friedemann03/Plant-Controller/docs/images/Software_BlockDiagram.png

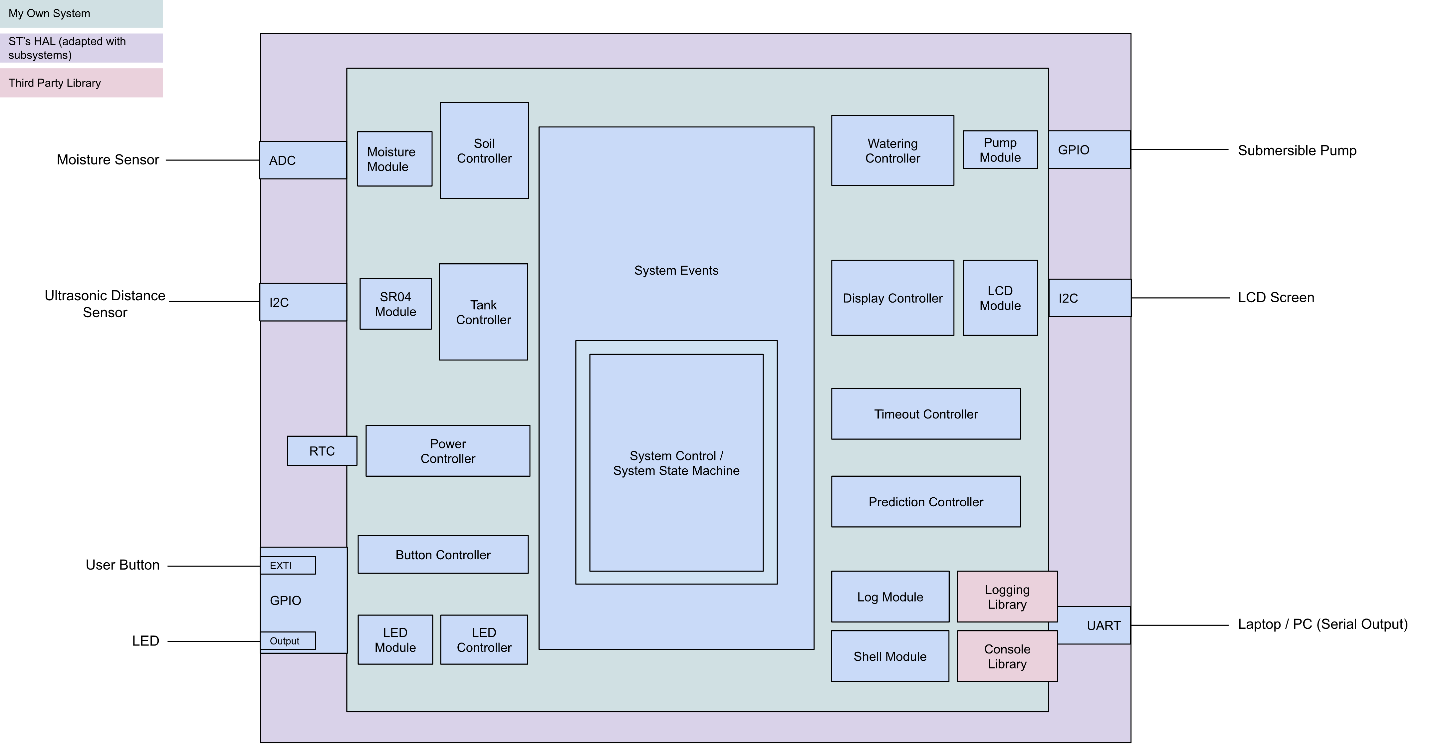
docs/images/Software_BlockDiagram.png
