friedemann03/Plant-Controller/docs/todo.md

# Todo
- [ ] Test Pump System
- [ ] Build the actual system with soil and water tank
- [ ] Design Prediction Controller
- [ ] Implement Prediction Controller
- [ ] Test the whole system

## Future Todos
- [ ] design and build Nucleo Shield PCB
