friedemann03/Plant-Controller/(threads)

Thread 3 (2022-10-17):

System halts when HC-SR04 Sensor's I2C is disconnected

friedemann03, 2022-10-17:
When the Update Function of the Tank Controller gets called while the I2C lines are disconnected, it halts the system, meaning the UART receives nothing anymore and the LED stops blinking.

Thread 4 (2022-10-17):

After System wakes up from STOP Mode, the SR04 does not work anymore

friedemann03, 2022-10-17:
After Stop Mode, the SR04 only return 0mm. I have not yet traced to where this error originates from, could be the controller, the module or the I2C subsystem.

friedemann03, 2022-10-17:
I found the cause of the issue.
The Tank Controller has a state variable (bool) used to see if a started measurement has completed. When entering STOP mode that variable may be left on false, which will cause the Tank Controller to never start a new Measurement.

Solution: After Exiting STOP mode, call the Controller Init function and add an initialisation of that variable to true, to make sure a new measurement gets started.
