friedemann03/Plant-Controller/docs/schematics/prototype_schematic.pdf

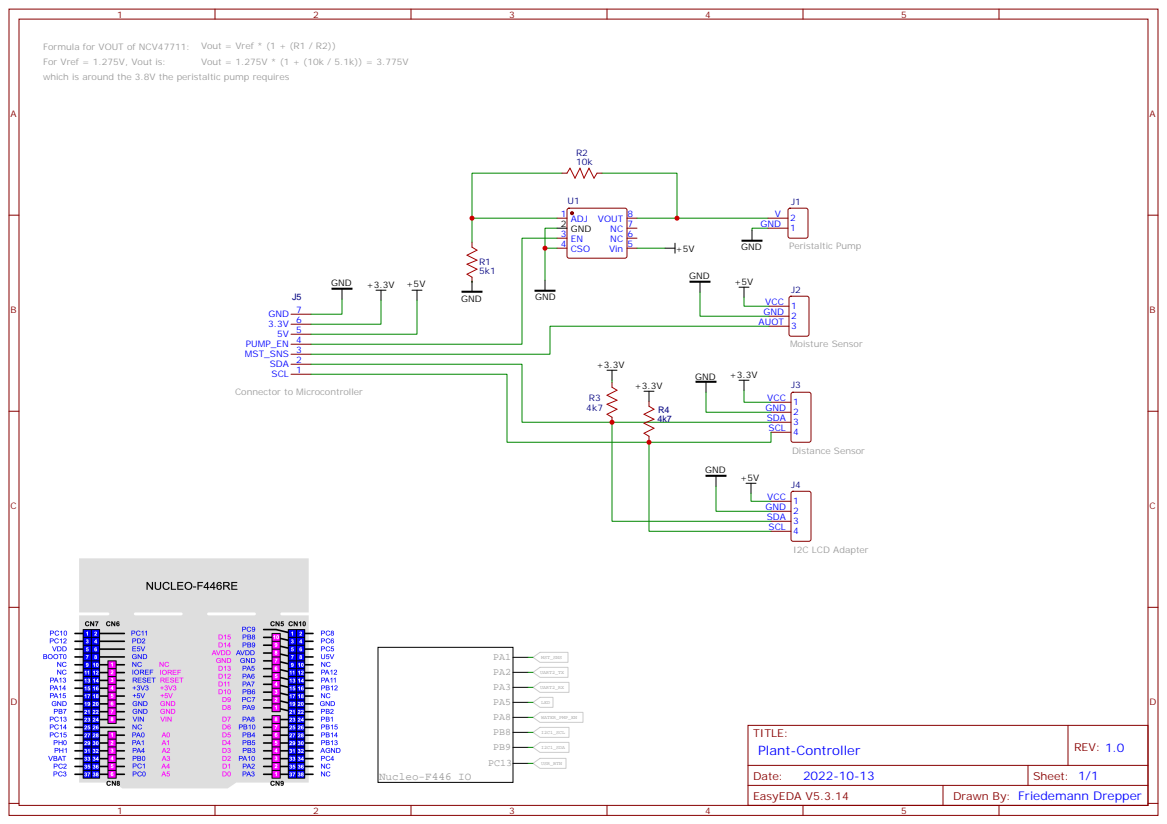
[picture p6: page 1]

Formula for VOUT of NCV47711:
which is around the 3.8V the peristaltic pump requires
