friedemann03/Plant-Controller/Core/Src/main.c

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
/* Includes ------------------------------------------------------------------*/
#include "main.h"

/* USER CODE BEGIN Includes */
#include "subsystem_uart.h"
#include "subsystem_tim.h"
#include "subsystem_gpio.h"
#include "subsystem_i2c.h"
#include "subsystem_adc.h"
#include "subsystem_rtc.h"
#include "log_module.h"
#include "version.h"
#include "system_control.h"
/* USER CODE END Includes */


void SystemClock_Config(void);
/**
  * @brief  The application entry point.
  * @retval int
  */
int main(void)
{
  /* MCU Configuration--------------------------------------------------------*/

  /* Reset of all peripherals, Initializes the Flash interface and the Systick. */
  HAL_Init();

  /* Configure the system clock */
  SystemClock_Config();

  /* Initialize all configured peripherals */
  /* USER CODE BEGIN 2 */

  Uart_Subsystem_Init();
  Log_Module_Init();

  Reset_Log();

  Gpio_Subsystem_Init();
  Tim_Subsystem_Init();
  I2c_Subsystem_Init();
  Adc_Subsystem_Init();
  Rtc_Subsystem_Init();

  System_Control_Init();
  System_Control_Start();
  /* USER CODE END 2 */

  /* Infinite loop */
  /* USER CODE BEGIN WHILE */
#pragma clang diagnostic push
#pragma ide diagnostic ignored "EndlessLoop"
#pragma ide diagnostic ignored "UnreachableCode"
  while (1)
  {
    /* USER CODE END WHILE */

    /* USER CODE BEGIN 3 */

  }
#pragma clang diagnostic pop
  /* USER CODE END 3 */
}

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
