friedemann03/Plant-Controller/Core/Inc/main.h

#define B1_Pin LL_GPIO_PIN_13
#define B1_GPIO_Port GPIOC
#define B1_EXTI_IRQn EXTI15_10_IRQn
#define MOISTURE_SENSOR_IN_Pin LL_GPIO_PIN_1
#define MOISTURE_SENSOR_IN_GPIO_Port GPIOA
#define USART_TX_Pin LL_GPIO_PIN_2
#define USART_TX_GPIO_Port GPIOA
#define USART_RX_Pin LL_GPIO_PIN_3
#define USART_RX_GPIO_Port GPIOA
#define LD2_Pin LL_GPIO_PIN_5
#define LD2_GPIO_Port GPIOA
#define WATER_PUMP_EN_Pin LL_GPIO_PIN_8
#define WATER_PUMP_EN_GPIO_Port GPIOA
#define TMS_Pin LL_GPIO_PIN_13
#define TMS_GPIO_Port GPIOA
#define TCK_Pin LL_GPIO_PIN_14
#define TCK_GPIO_Port GPIOA
#define SWO_Pin LL_GPIO_PIN_3
#define SWO_GPIO_Port GPIOB
#define US_SCL_Pin LL_GPIO_PIN_8
#define US_SCL_GPIO_Port GPIOB
#define US_SDA_Pin LL_GPIO_PIN_9
#define US_SDA_GPIO_Port GPIOB
