friedemann03/Plant-Controller/inc/pinout.h

//
// Created by Friedemann Drepper on 14.09.22.
//

#ifndef YS_EXERCISE_WEEK3_PINOUT_H
#define YS_EXERCISE_WEEK3_PINOUT_H

#include "subsystem_gpio.h"

#define LED2_Pin Gpio_Pin_5
#define LED2_GPIO_Port Gpio_Port_A

#define USER_BTN_Pin Gpio_Pin_13
#define USER_BTN_GPIO_Port Gpio_Port_C

#endif //YS_EXERCISE_WEEK3_PINOUT_H
