friedemann03/Plant-Controller/inc/controller_power.h

//
// Created by Friedemann Drepper on 17.10.22.
//

#ifndef PLANT_CONTROLLER_CONTROLLER_POWER_H
#define PLANT_CONTROLLER_CONTROLLER_POWER_H

void Power_Controller_StopMode(void);





#endif //PLANT_CONTROLLER_CONTROLLER_POWER_H
