friedemann03/Plant-Controller/inc/controller_watering.h

//
// Created by Friedemann Drepper on 25.10.22.
//

#ifndef PLANT_CONTROLLER_CONTROLLER_WATERING_H
#define PLANT_CONTROLLER_CONTROLLER_WATERING_H

void Watering_Controller_Init(void);

void Watering_Controller_WaterPlant(void);


#endif //PLANT_CONTROLLER_CONTROLLER_WATERING_H
