friedemann03/Plant-Controller/inc/controller_timeout.h

//
// Created by Friedemann Drepper on 21.10.22.
//

#ifndef PLANT_CONTROLLER_CONTROLLER_TIMEOUT_H
#define PLANT_CONTROLLER_CONTROLLER_TIMEOUT_H

#endif //PLANT_CONTROLLER_CONTROLLER_TIMEOUT_H

#include "stdbool.h"


void Timeout_Controller_Init(void);

void Timeout_Controller_Enable(bool status);

void Timeout_Controller_Reset(void);
