friedemann03/Plant-Controller/inc/system_control.h

//
// Created by Friedemann Drepper on 17.10.22.
//

#ifndef PLANT_CONTROLLER_SYSTEM_CONTROL_H
#define PLANT_CONTROLLER_SYSTEM_CONTROL_H

#include "stdint.h"


void System_Control_Init(void);

_Noreturn void System_Control_Start(void); // will never return


#endif //PLANT_CONTROLLER_SYSTEM_CONTROL_H
