friedemann03/Plant-Controller/inc/config.h

//
// Created by Friedemann Drepper on 26.10.22.
//

#ifndef PLANT_CONTROLLER_CONFIG_H
#define PLANT_CONTROLLER_CONFIG_H


#define SOIL_DRY        1650
#define SOIL_WET        1200
#define TANK_EMPTY      160


#endif //PLANT_CONTROLLER_CONFIG_H
