friedemann03/Plant-Controller/inc/shell.h

//
// Created by Friedemann Drepper on 30.09.22.
//

#ifndef MES_BLINKY_SHELL_H
#define MES_BLINKY_SHELL_H

/* Includes ------------------------------------------------------------------*/
#include "anchor/console/console.h"


/* Exported macro ------------------------------------------------------------*/

/* Exported types ------------------------------------------------------------*/

/* Exported constants --------------------------------------------------------*/

/* Exported functions prototypes ---------------------------------------------*/
void Shell_Init(void);

bool Shell_Read_Function(void);


#endif //MES_BLINKY_SHELL_H
