friedemann03/Plant-Controller/inc/log_module.h

//
// Created by Friedemann Drepper on 07.10.22.
//

#ifndef PLANT_CONTROLLER_LOG_MODULE_H
#define PLANT_CONTROLLER_LOG_MODULE_H

#include "anchor/logging/logging.h"
#include "log_module_colors.h"

void Log_Module_Init(void);

#endif //PLANT_CONTROLLER_LOG_MODULE_H
