friedemann03/Plant-Controller/inc/log_module_colors.h

//
// Created by Friedemann Drepper on 07.10.22.
//

#ifndef PLANT_CONTROLLER_LOG_MODULE_COLORS_H
#define PLANT_CONTROLLER_LOG_MODULE_COLORS_H

/* Exported macro ------------------------------------------------------------*/
#define CTRL_RESET                "\x1B[0m"         // Reset to default colors

#define CTRL_TEXT_BRIGHT_RED      "\x1B[1;31m"
#define CTRL_TEXT_BRIGHT_GREEN    "\x1B[1;32m"
#define CTRL_TEXT_BRIGHT_YELLOW   "\x1B[1;33m"
#define CTRL_TEXT_BRIGHT_BLUE     "\x1B[1;34m"




#endif //PLANT_CONTROLLER_LOG_MODULE_COLORS_H
