friedemann03/Plant-Controller/inc/version.h

//
// Created by Friedemann Drepper on 07.10.22.
//

#ifndef PLANT_CONTROLLER_VERSION_H
#define PLANT_CONTROLLER_VERSION_H

/* Includes ------------------------------------------------------------------*/
#include "stdint.h"

/* Exported functions prototypes ---------------------------------------------*/
void Reset_Log(void);


#endif //PLANT_CONTROLLER_VERSION_H
