friedemann03/Plant-Controller/inc/unit_testing.h

//
// Created by Friedemann Drepper on 19.09.22.
//

#ifndef YS_EXERCISE_WEEK3_UNIT_TESTING_H
#define YS_EXERCISE_WEEK3_UNIT_TESTING_H

#ifdef UNIT_TESTS
#define STATIC
#else
#define STATIC static
#endif

#endif //YS_EXERCISE_WEEK3_UNIT_TESTING_H
