friedemann03/Plant-Controller/(commit log)

2022-08-30 generated code with cubemx with all default peripherals for disco board
2022-08-31 fixed issue with HSE and switched to LL Driver everywhere possible
    [main.c, main.h]
2022-08-31 added LL driver in cmake
2022-08-31 added simple led blink program in main
2022-09-23 copies blinky project over and replaced everything
    [controller_led.c, controller_led.h, log_module.c, log_module.h, main.c, main.h, pinout.h]
2022-10-07 changed TIM10 update freq to 10Hz
2022-10-07 added led module
2022-10-07 rewrote the led controller to use the led module
2022-10-07 edited testing command for led controller and module
2022-10-07 added logging lib, fixed it, added module to use library, added builds
    [log_module.c, log_module.h, shell.c]
2022-10-07 added init of version module and call to reset log
    [main.c]
2022-10-11 added I2C1 and TIM11 and generated code
2022-10-11 added interrupt for TIM11
2022-10-11 added files for i2c subsystem
2022-10-11 added i2c subsystem
2022-10-11 changed tim code gen to use LL driver
2022-10-11 added interrupt handling and callback to tim11 irq
2022-10-11 changed I2C1 pins
2022-10-11 fixed issues with address and distance calculation
    [module_sr04.c]
2022-10-11 fixed linker error due to wrong function names
    [subsystem_i2c.c]
2022-10-11 added command to shell to get distance from sensor
2022-10-12 added timer disabling in tank controller
2022-10-12 fixed missing function prototype and calls to old functions
    [controller_display.c, controller_display.h]
2022-10-12 changed string building in print functions
2022-10-13 added files for adc subsystem
2022-10-13 very simple implementation of adc subsystem
2022-10-13 added PA8 gpio output for the pump enable line
2022-10-13 added files for pump module
2022-10-13 implemented pump module
2022-10-13 added soil moisture print to display outputs
2022-10-13 added helper function to print to lcd display
2022-10-13 added prototype schematic
2022-10-17 added files for power controller
2022-10-17 set all free pins to analog to reduce power consumption
2022-10-17 changed deinit to leave out jtag pins and changed to ll driver
2022-10-17 added power controller implementation
2022-10-17 enabled RTC WakeUp Interrupt in CubeMX
2022-10-17 added displaying current time in test screen
2022-10-17 added TIM1 with 1Hz in CubeMX
2022-10-17 added TIM1 to Timer Subsystem
2022-10-17 replaced TIM1 with TIM2 due to Interrupt Conflict with other Timer
    [controller_display.c, subsystem_tim.c, subsystem_tim.h]
2022-10-18 added fix for leaving stop mode issue
    [controller_tank.c]
2022-10-18 fixed event array size
    [system_control.c]
2022-10-19 replaced clear and set event functions with one trigger function
    [system_events.c, system_events.h]
2022-10-21 added TIM5 interrupt callback and handling
2022-10-21 added reset counter function
    [subsystem_tim.c, subsystem_tim.h]
2022-10-21 fixed typo in init function name
    [controller_timeout.c, controller_timeout.h]
2022-10-21 added timeout reset command to console
    [shell.c]
2022-10-21 fixed reset function to clear interrupt flag bit
    [subsystem_tim.c]
2022-10-21 added missing break in switch statement
    [system_control.c]
2022-10-21 added resetting the timeout if char is received in console
    [system_control.c]
2022-10-21 added files for button controller
2022-10-21 added tim3 for button controller in cubemx and subsystem
2022-10-21 changed return type of input pin read function
2022-10-21 implemented button controller
2022-10-21 moved button interrupt to button controller
2022-10-21 added button controller functionalities to power controller
2022-10-21 added button controller functionalities to system control
2022-10-21 changed interrupt mode to falling trigger detection for user button
2022-10-21 added checking for interrupt enabled flag in IRQ Handlers
2022-10-21 added logging to interrupt stages
2022-10-25 added IRQ enabling for led timer
2022-10-26 changed wakeup detection to use rtc interrupt
2022-10-26 fixed issues in checking sensor values against limits
    [controller_soil.c, controller_tank.c]
2022-10-26 added special display functions for watering and errors
    [controller_display.c, controller_display.h, system_control.c]
2022-10-31 fixed wrong delay numbers
    [controller_watering.c]
2022-11-01 changed exit event for tank error state to button press
    [system_control.c]
2022-11-02 replaced blocking wait with stop mode delaying
    [controller_watering.c, system_control.c]
2022-11-02 changed HCLK freq to 4MHz and enabled CSS, adjusted timers
2022-11-07 fixed issue with wakeup source detection after lowering HCLK
    [controller_power.c]
2022-11-14 added nessecary static to make pump variable private to file
2022-11-14 added pump toggling command
2022-11-14 added timer interrupt callback definition
2022-11-16 fixed small mistake in array avg function
    [controller_prediction.c]
2022-11-16 fixed typo mistake in calculating hours from seconds
    [controller_prediction.c]
2022-11-16 changed time of active pump to half a second
2022-11-16 fixed error with wakeup event blocking soil event
    [system_control.c]
2022-11-19 fixed mistake in comparing to limits
    [controller_soil.c]
2022-11-19 fixed system lockup in periodic check state due to no event
    [system_control.c]
2022-11-19 added initial sensor readings and debug logging of them
2022-11-19 fixed button controller not being enabled in tank empty state
    [system_control.c]
2022-11-19 fixed system lockup in periodic check
    [system_control.c]
